dallegre/reverbboard/dsp.brd

## EAGLE design dsp.brd (2021-03-25)

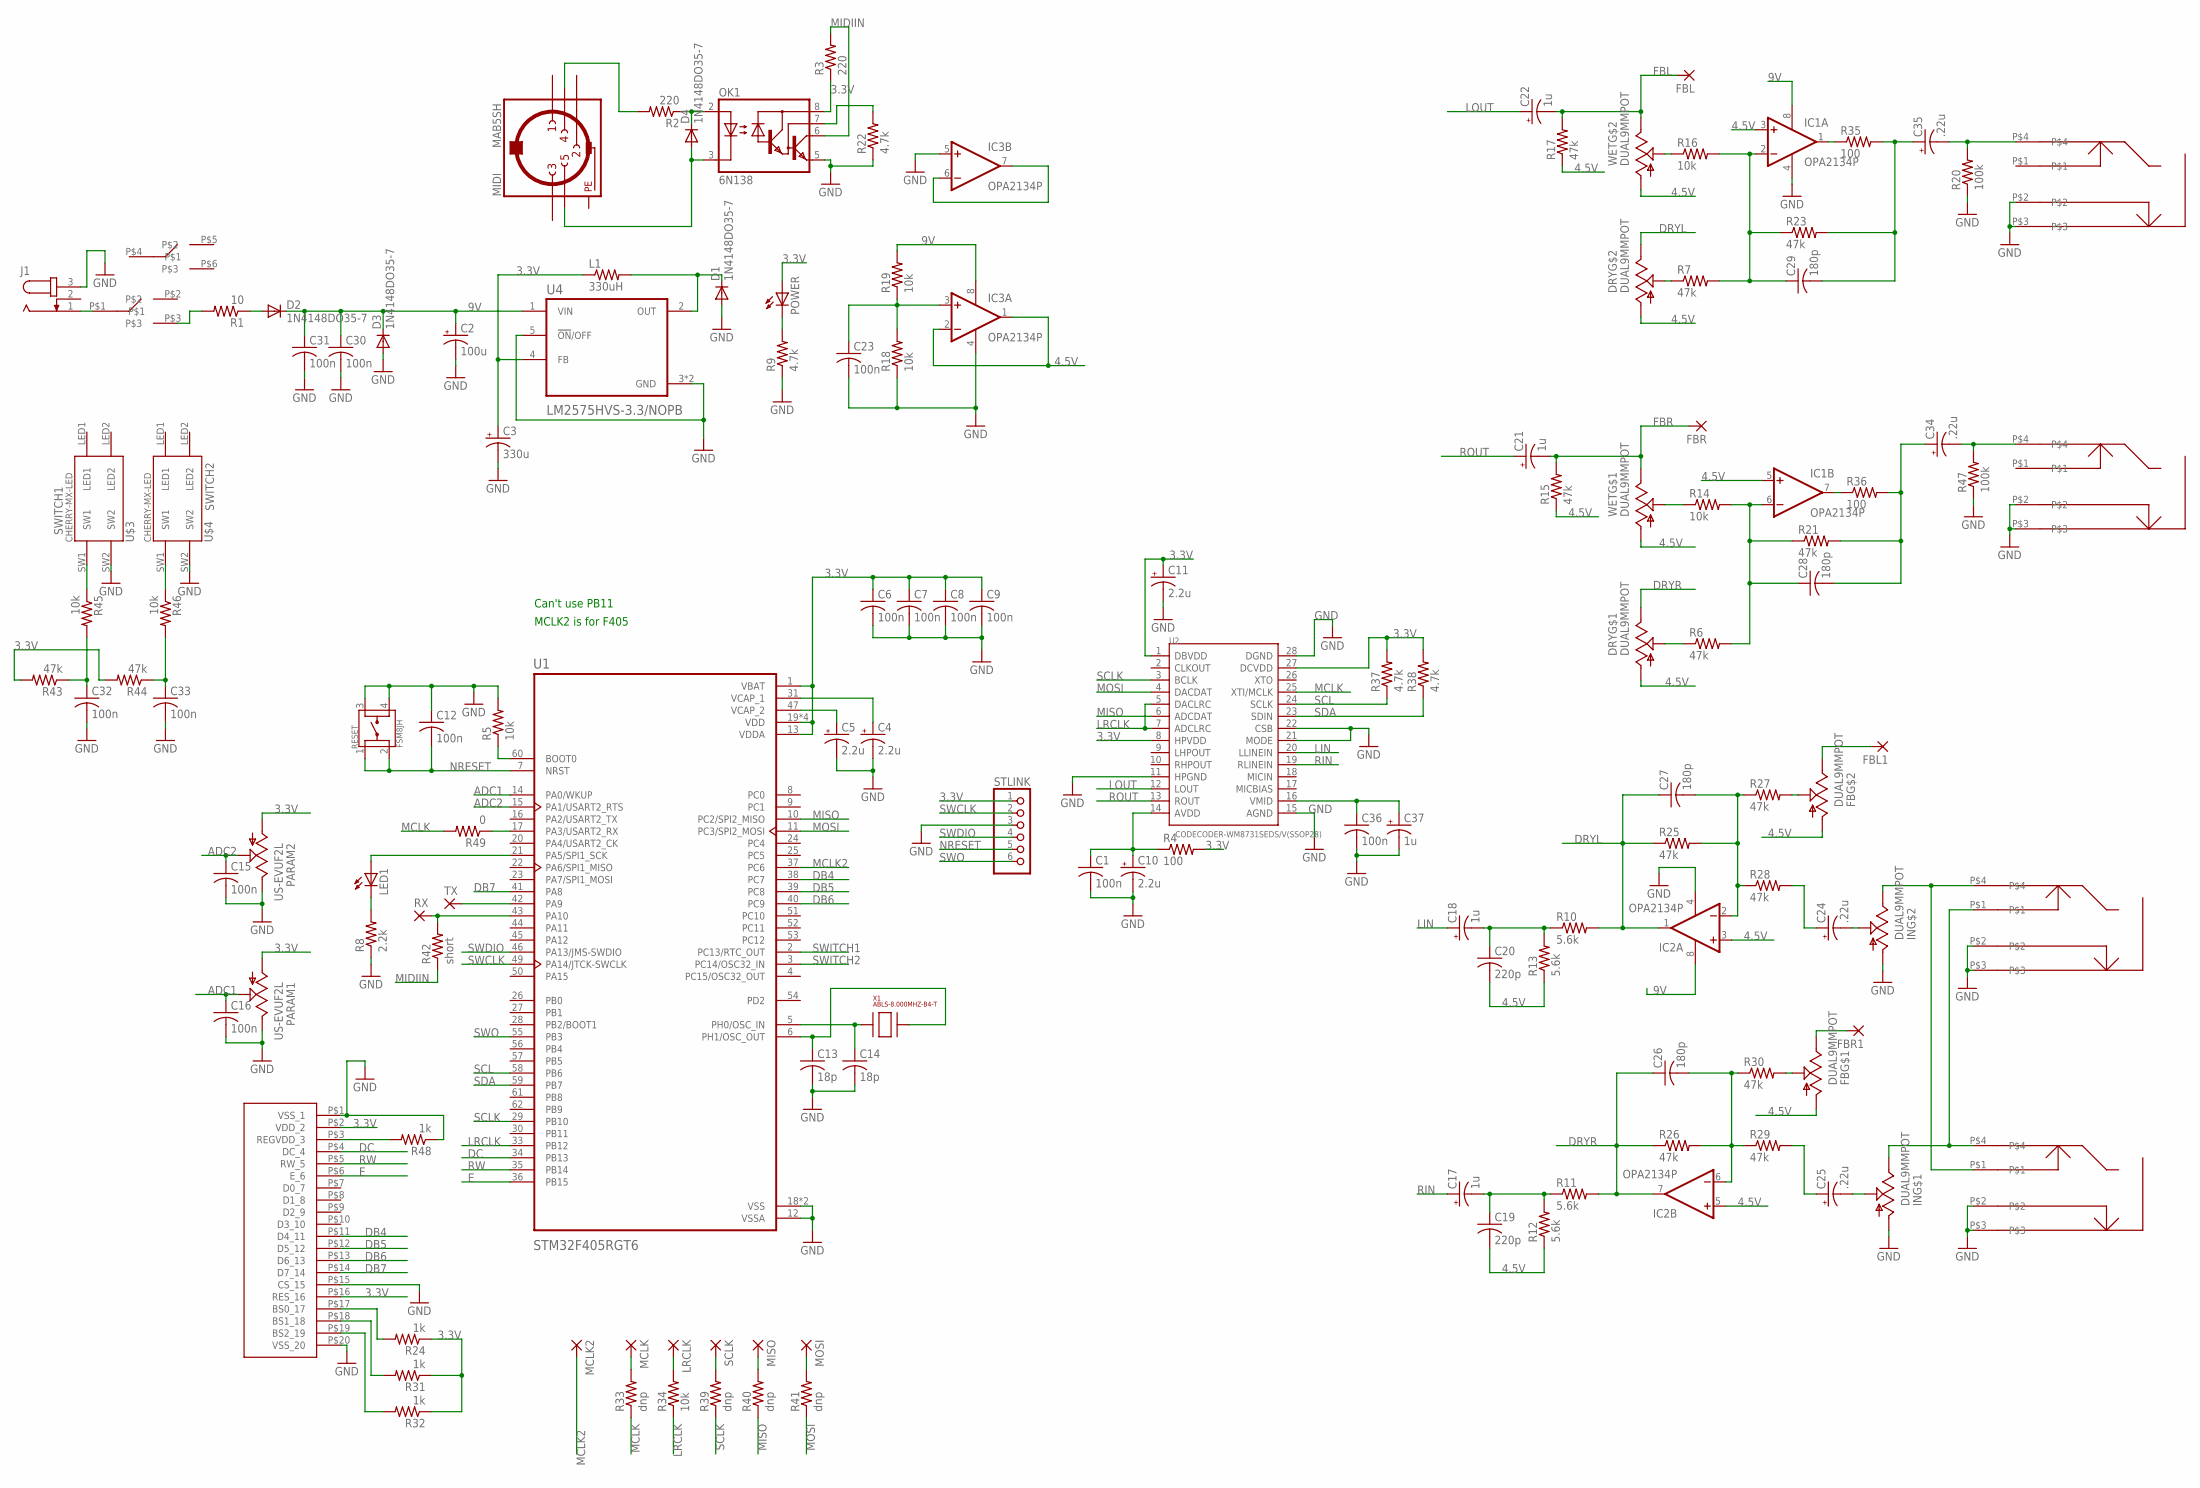
[picture p1: schematic dsp.sch]

Parts:
C1, C6, C7, C8, C9, C12, C15, C16, C23, C30, C31, C32, C33, C36: 100n; C050-025X075
C2: 100u; E2,5-7
C3: 330u; E3,5-8
C4, C5, C11: 2.2u; E2-4
C10: 2.2u; E2-5
C13, C14: 18p; C0603
C17, C18, C21, C22: 1u; E2,5-7
C19, C20: 220p; C050-025X075
C24, C25, C34, C35: .22u; E2,5-7
C26, C27, C28, C29: 180p; C050-025X075
C37: 1u; E2-4
D1, D2, D3, D4: 1N4148DO35-7; DO35-7
DRY: DUAL9MMPOT
FB: DUAL9MMPOT
FBL, FBL1: 2,0/0,9-S
FBR, FBR1: 2,0/0,9-S
IC1, IC2, IC3: OPA2134P; DIL08
IN: DUAL9MMPOT
INL: NMJ4HCD2
INR: NMJ4HCD2
J1: JACK-PLUG0; SPC4077
L1: 330uH; 0207/7
LED1: LED5MM
LRCLK: 2,0/0,9-S
MCLK, MCLK2: 2,0/0,9-S
MIDI: MAB5SH
MISO: 2,0/0,9-S
MOSI: 2,0/0,9-S
OK1: 6N138; DIL08
OUTL: NMJ4HCD2
OUTR: NMJ4HCD2
PARAM1, PARAM2: US-EVUF2L; EVUFXL
POWER: LED5MM
R1: 10; 0309V
R2, R3: 220; 0309V
R4, R35, R36: 100; 0309V
R5, R34: 10k; R0603
R6, R7, R15, R17, R21, R23, R25, R26, R27, R28, R29, R30, R43, R44: 47k; 0309V
R8: 2.2k; 0309V
R9, R22: 4.7k; 0309V
R10, R11, R12, R13: 5.6k; 0309V
R14, R16, R18, R19, R45, R46: 10k; 0309V
R20, R47: 100k; 0309V
R24, R31, R32, R48: 1k; 0309V
R33, R39, R40, R41: dnp; R0603
R37, R38: 4.7k; R0603
R42: short; 0309V
R49: 0; R0603
RESET: FSM8JH; SW_FSM8JH
RX: 2,0/0,9-S
SCLK: 2,0/0,9-S
STLINK: PINHD-1X6; 1X06
TX: 2,0/0,9-S
U1: STM32F405RGT6; QFP50P1200X1200X160-64N
U2: CODECODER-WM8731SEDS/V(SSOP28); SSOP28-0.65-10.2X5.2MM
U4: LM2575HVS-3.3/NOPB; VREG_TPS79625KTTR
U$1: NHD-0420CW
U$2: LC2255
U$3, U$4: CHERRY-MX-LED
WET: DUAL9MMPOT
X1: ABLS-8.000MHZ-B4-T; HC-49/US

Connections:
3.3V: C3.+, C6.1, C7.1, C8.1, C9.1, C11.+, L1.1, OK1.8 (VCC), PARAM1.1 (A), PARAM2.1 (A), POWER.A, R3.1, R4.2, R24.1, R31.1, R32.1, R37.2, R38.2, R43.2, R44.2, STLINK.1, U1.1 (VBAT), U1.13 (VDDA), U1.19 (VDD), U1.32 (VDD), U1.48 (VDD), U1.64 (VDD), U2.1 (DBVDD), U2.8 (HPVDD), U2.27 (DCVDD), U4.4 (FB), U$1.P$2 (VDD_2), U$1.P$16 (RES_16)
4.5V: C19.2, C20.2, DRY.1 (A), DRY.4 (A), FB.1 (A), FB.4 (A), IC1.3 (+IN), IC1.5 (+IN), IC2.3 (+IN), IC2.5 (+IN), IC3.1 (OUT), IC3.2 (-IN), R12.1, R13.1, R15.1, R17.1, WET.1 (A), WET.4 (A)
9V: C2.+, C30.1, C31.1, D2.C, D3.C, IC1.8 (V+), IC2.8 (V+), IC3.8 (V+), R19.2, U4.1 (VIN)
ADC1: C16.1, PARAM1.2 (S), U1.14 (PA0/WKUP)
ADC2: C15.1, PARAM2.2 (S), U1.15 (PA1/USART2_RTS)
DB4: U1.38 (PC7), U$1.P$11 (D4_11)
DB5: U1.39 (PC8), U$1.P$12 (D5_12)
DB6: U1.40 (PC9), U$1.P$13 (D6_13)
DB7: U1.41 (PA8), U$1.P$14 (D7_14)
DC: U1.34 (PB13), U$1.P$4 (DC_4)
DRYL: C27.1, DRY.6 (E), IC2.1 (OUT), R10.2, R25.1
DRYR: C26.1, DRY.3 (E), IC2.7 (OUT), R11.2, R26.1
E: U1.36 (PB15), U$1.P$6 (E_6)
FBL: C22.-, FBL.1, R17.2, WET.6 (E)
FBR: C21.-, FBR.1, R15.2, WET.3 (E)
GND: C1.2, C2.-, C3.-, C4.-, C5.-, C6.2, C7.2, C8.2, C9.2, C10.-, C11.-, C12.1, C13.2, C14.2, C15.2, C16.2, C23.2, C30.2, C31.2, C32.2, C33.2, C36.2, C37.-, D1.A, D3.A, IC1.4 (V-), IC2.4 (V-), IC3.4 (V-), IC3.5 (+IN), IN.1 (A), IN.4 (A), INL.P$2, INL.P$3, INR.P$2, INR.P$3, J1.3, OK1.5 (GND), OUTL.P$2, OUTL.P$3, OUTR.P$2, OUTR.P$3, PARAM1.3 (E), PARAM2.3 (E), R5.2, R8.1, R9.1, R18.1, R20.1, R22.1, R47.1, R48.1, RESET.3, RESET.4, STLINK.3, U1.12 (VSSA), U1.18 (VSS), U1.63 (VSS), U2.11 (HPGND), U2.15 (AGND), U2.21 (MODE), U2.22 (CSB), U2.28 (DGND), U4.3 (GND), U4.5 (!ON!/OFF), U4.6 (GND), U$1.P$1 (VSS_1), U$1.P$15 (CS_15), U$1.P$20 (VSS_20), U$3.SW2, U$4.SW2
LIN: C18.+, U2.20 (LLINEIN)
LOUT: C22.+, U2.12 (LOUT)
LRCLK: R34.1, U1.33 (PB12), U2.5 (DACLRC), U2.7 (ADCLRC)
MCLK: R33.1, R49.2, U2.25 (XTI/MCLK)
MCLK2: MCLK2.1, U1.37 (PC6)
MIDIIN: OK1.6 (VO), R3.2, R42.1
MISO: R40.1, U1.10 (PC2/SPI2_MISO), U2.6 (ADCDAT)
MOSI: R41.1, U1.11 (PC3/SPI2_MOSI), U2.4 (DACDAT)
unnamed: C4.+, U1.31 (VCAP_1)
unnamed: C5.+, U1.47 (VCAP_2)
unnamed: D2.A, R1.1
unnamed: D1.C, L1.2, U4.2 (OUT)
unnamed: C1.1, C10.+, R4.1, U2.14 (AVDD)
unnamed: R1.2, U$2.P$3
unnamed: R5.1, U1.60 (BOOT0)
unnamed: TX.1, U1.42 (PA9)
unnamed: LED1.A, U1.21 (PA5/SPI1_SCK)
unnamed: LED1.K (C), R8.2
unnamed: POWER.K (C), R9.2
unnamed: C13.1, U1.6 (PH1/OSC_OUT), X1.P$2 (3)
unnamed: C14.1, U1.5 (PH0/OSC_IN), X1.P$1 (1)
unnamed: FB.2 (S), R30.2
unnamed: C17.-, C19.1, R11.1, R12.2
unnamed: FB.5 (S), R27.2
unnamed: C18.-, C20.1, R10.1, R13.2
unnamed: C29.1, IC1.2 (-IN), R7.2, R16.2, R23.1
unnamed: C28.1, IC1.6 (-IN), R6.2, R14.2, R21.1
unnamed: C23.1, IC3.3 (+IN), R18.2, R19.1
unnamed: R14.1, WET.2 (S)
unnamed: R16.1, WET.5 (S)
unnamed: C28.2, C34.+, R21.2, R36.2
unnamed: C29.2, C35.+, R23.2, R35.2
unnamed: R49.1, U1.17 (PA3/USART2_RX)
unnamed: C24.+, R28.2
unnamed: C27.2, IC2.2 (-IN), R25.2, R27.1, R28.1
unnamed: C26.2, IC2.6 (-IN), R26.2, R29.1, R30.1
unnamed: IN.3 (E), INL.P$1, INR.P$4
unnamed: C25.+, R29.2
unnamed: IC1.7 (OUT), R36.1
unnamed: IC1.1 (OUT), R35.1
unnamed: C24.-, IN.5 (S)
unnamed: C25.-, IN.2 (S)
unnamed: DRY.2 (S), R6.1
unnamed: DRY.5 (S), R7.1
unnamed: J1.1, U$2.P$1
unnamed: OK1.7 (VB), R22.2
unnamed: D4.C, OK1.2 (A), R2.1
unnamed: MIDI.4, R2.2
unnamed: D4.A, MIDI.5, OK1.3 (C)
unnamed: R32.2, U$1.P$19 (BS2_19)
unnamed: R31.2, U$1.P$18 (BS1_18)
unnamed: R24.2, U$1.P$17 (BS0_17)
unnamed: MCLK.1, R33.2
unnamed: LRCLK.1, R34.2
unnamed: R39.2, SCLK.1
unnamed: MISO.1, R40.2
unnamed: MOSI.1, R41.2
unnamed: R42.2, RX.1, U1.43 (PA10)
unnamed: R45.1, U$3.SW1
unnamed: R46.1, U$4.SW1
unnamed: C35.-, OUTL.P$4, R20.2
unnamed: C34.-, OUTR.P$4, R47.2
unnamed: FB.6 (E), FBL1.1
unnamed: FB.3 (E), FBR1.1
unnamed: C36.1, C37.+, U2.16 (VMID)
unnamed: IN.6 (E), INL.P$4, INR.P$1
unnamed: R48.2, U$1.P$3 (REGVDD_3)
unnamed: IC3.6 (-IN), IC3.7 (OUT)
NRESET: C12.2, RESET.1, RESET.2, STLINK.5, U1.7 (NRST)
PE: MIDI.PE, MIDI.PE@ (PE)
RIN: C17.+, U2.19 (RLINEIN)
ROUT: C21.+, U2.13 (ROUT)
RW: U1.35 (PB14), U$1.P$5 (RW_5)
SCL: R37.1, U1.58 (PB6), U2.24 (SCLK)
SCLK: R39.1, U1.29 (PB10), U2.3 (BCLK)
SDA: R38.1, U1.59 (PB7), U2.23 (SDIN)
SWCLK: STLINK.2, U1.49 (PA14/JTCK-SWCLK)
SWDIO: STLINK.4, U1.46 (PA13/JMS-SWDIO)
SWITCH1: C32.1, R43.1, R45.2, U1.2 (PC13/RTC_OUT)
SWITCH2: C33.1, R44.1, R46.2, U1.3 (PC14/OSC32_IN)
SWO: STLINK.6, U1.55 (PB3)

Notes on the sheet:
Can't use PB11
MCLK2 is for F405

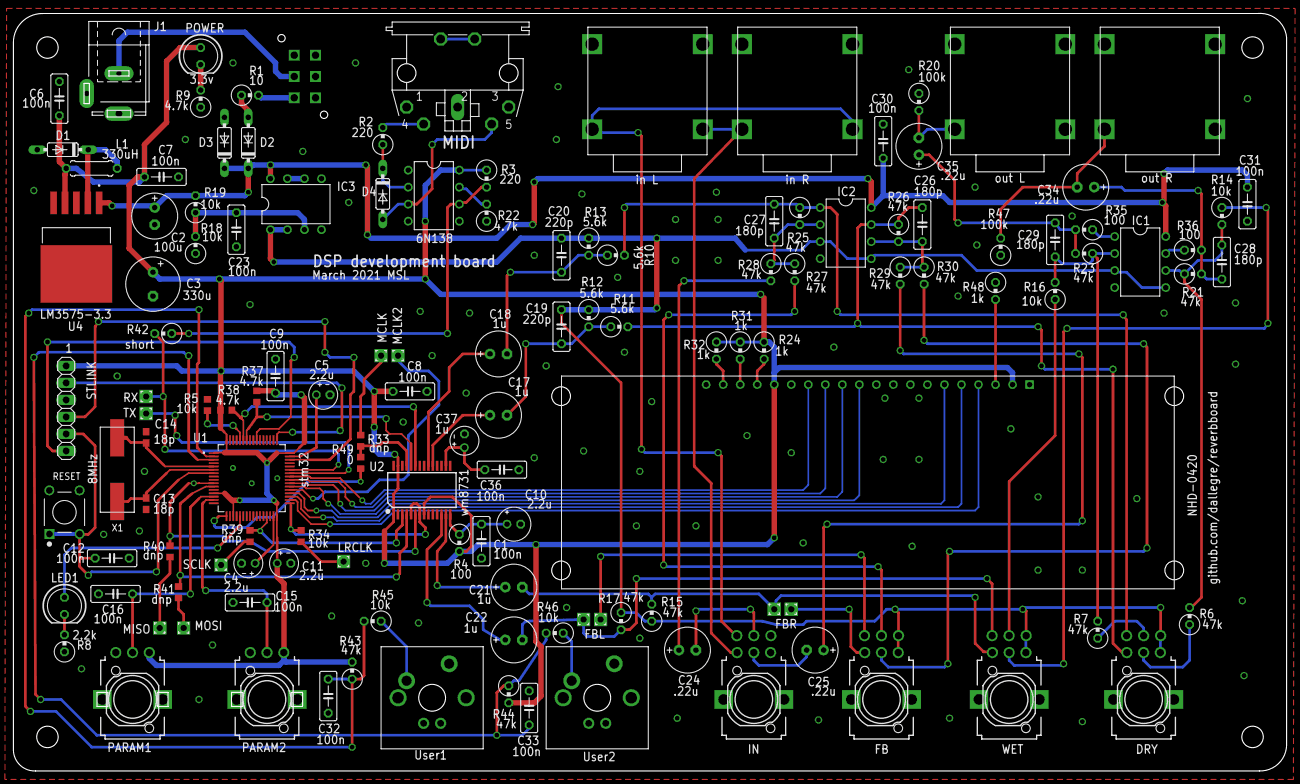
[picture p2: board dsp.brd from above]

Board: 2 copper layers, 190.0 x 113.0 mm, 131 parts (0 on the bottom side), 97 nets.
