dallegre/reverbboard/(commit log)

2021-03-08 fixed mclk and uart connections
    [dsp.brd, dsp.sch]
2021-03-08 changed virtual ground to an op amp buffer
    [dsp.brd, dsp.sch]
2021-03-08 mono routing, ac coupled op, jumper for feedback
    [dsp.brd, dsp.sch]
2021-03-08 routing for mono on both inputs
    [dsp.brd, dsp.sch]
2021-03-08 connected mode and csb on wm8731
    [dsp.brd, dsp.sch]
2021-03-09 added a ground for vccref and moved icp header to edge
    [dsp.brd, dsp.sch]
2021-03-10 added a mclk optin for pc6 for f405 compatibility
    [dsp.brd, dsp.sch]
2021-03-10 sent it out to get made
    [dsp.brd, dsp.sch]
2021-03-25 fixed grounds problem on codec (post fab)
    [dsp.brd, dsp.sch]
2021-03-25 updated mixer resistors for higher wet amplitude
    [dsp.brd, dsp.sch]
